hakierspejs/hsldz_totp_lock/docs/photos/photo_2021-01-16_19-56-42.jpg

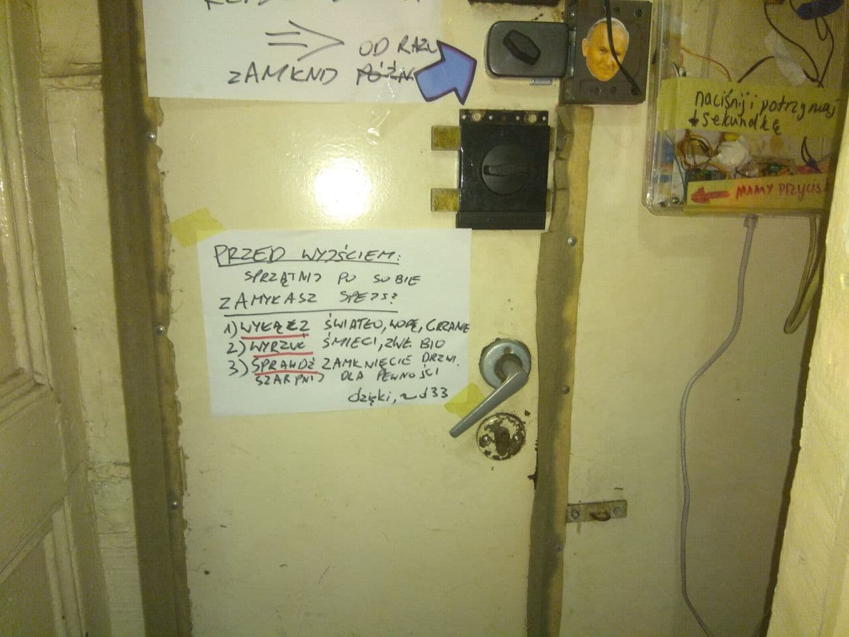
docs/photos/photo_2021-01-16_19-56-42.jpg
