hakierspejs/hsldz_totp_lock/(commit log)

2020-12-12 Attach vendor libraries
2024-06-30 Fix bug with serial device access in containers
2024-06-30 Add make commands for arduino nano
2024-06-30 Drop support for lock-open-button
